skot/bitcart/bitcart.kicad_pcb

## KiCad design bitcart.kicad_pcb (2023-10-17)

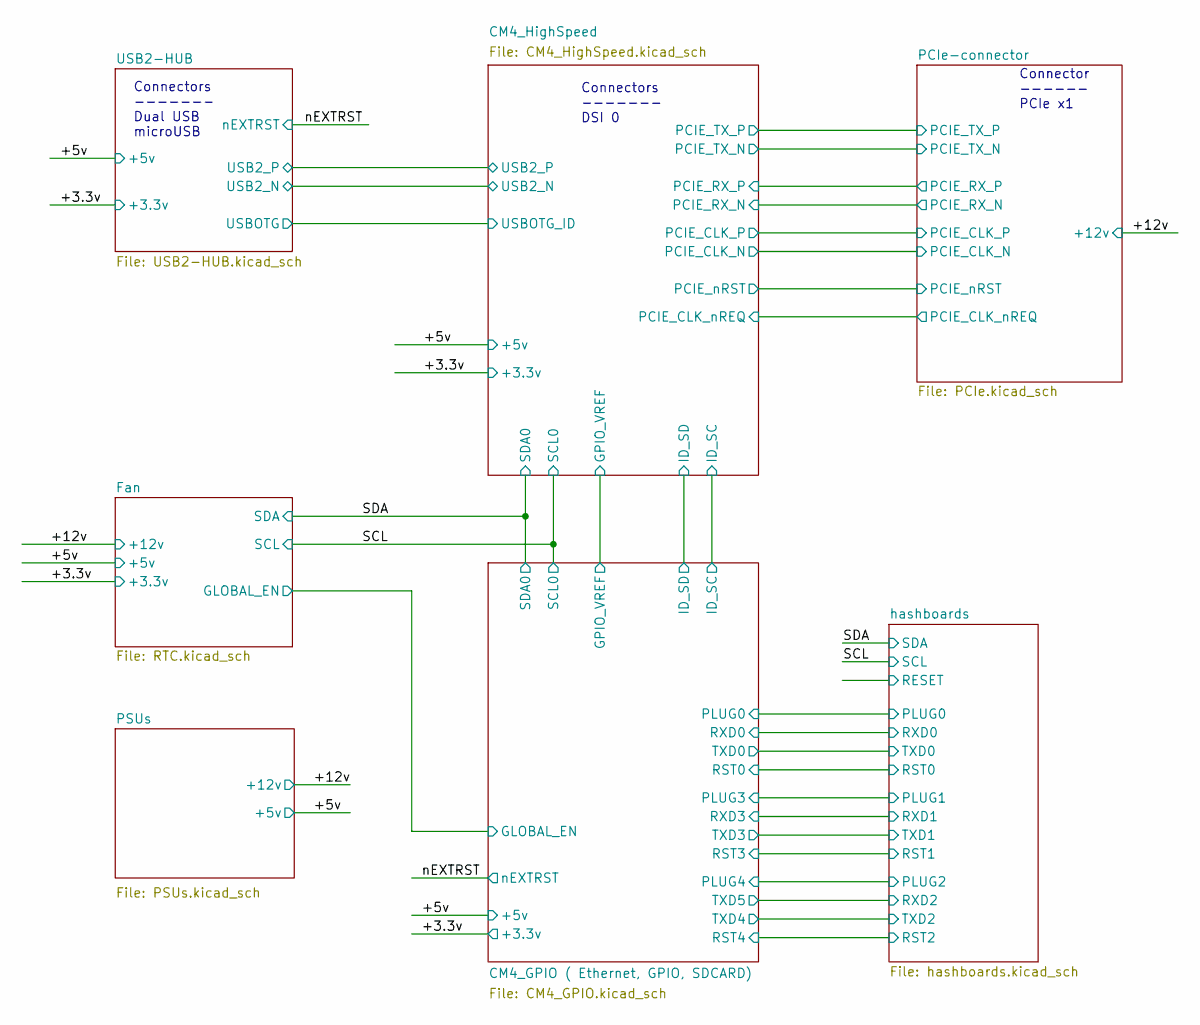
[picture p2: schematic bitcart.kicad_sch]

Notes on the sheet:
Connector ------ PCIe x1
Connectors ------- Dual USB microUSB
Connectors ------- DSI 0

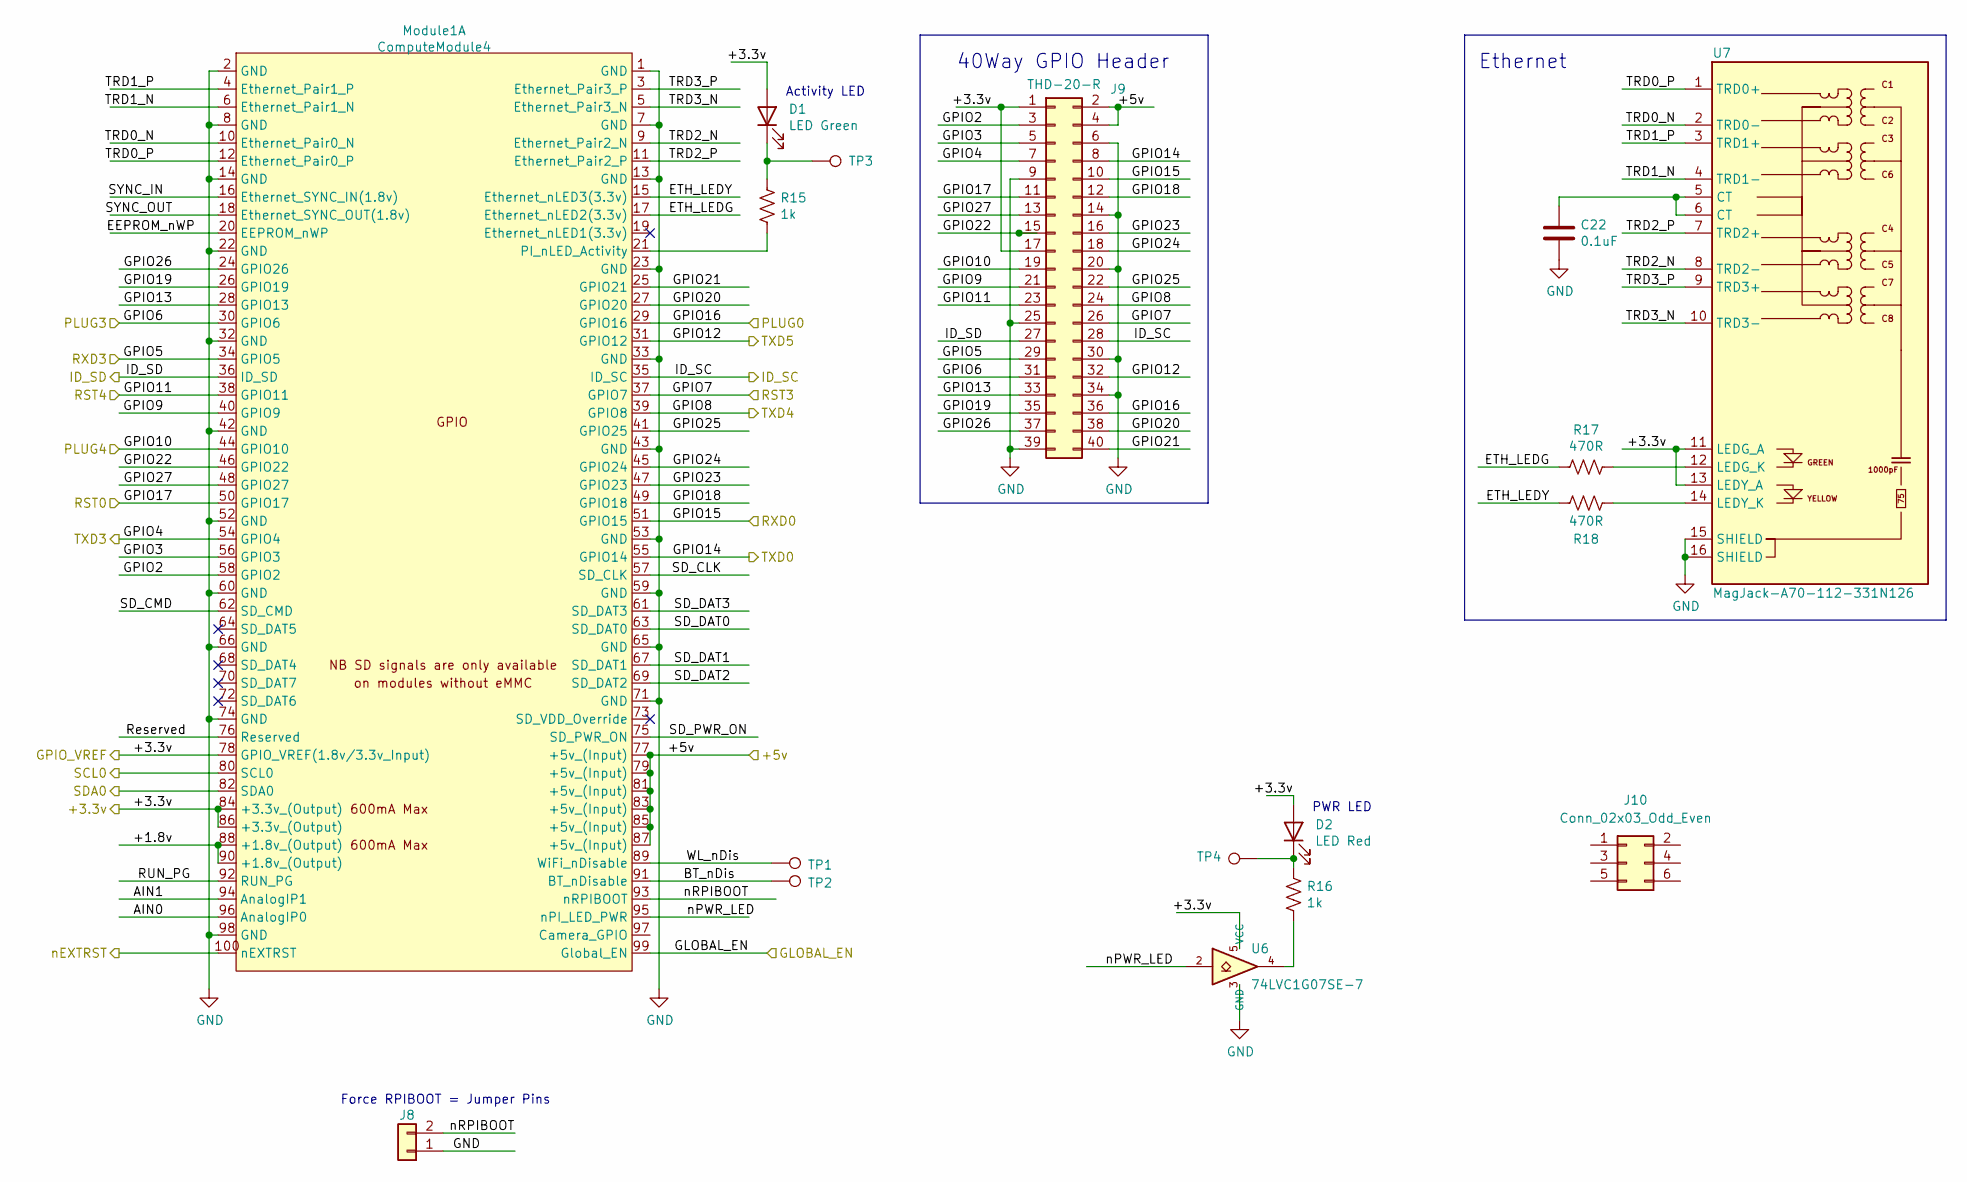
[picture p3: schematic CM4_GPIO.kicad_sch, Bitcart]

Parts:
C22: 0.1uF; C_0402_1005Metric; PARTNO KGM05AR71C104KH
D1: LED Green; LED_0603_1608Metric; PARTNO LTST-S270KGKT
D2: LED Red; LED_0603_1608Metric; Part Description Red 620nm LED Indication - Discrete 2.2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
J8: Conn_01x02; PinHeader_1x02_P2.54mm_Vertical
J9: THD-20-R; PinHeader_2x20_P2.54mm_Vertical; Part Description PinHeader_2x20_P2.54mm_Vertical
J10: Conn_02x03_Odd_Even; CONN-TH_6P-P2.00_PHD-2X3A
Module1: ComputeModule4; Raspberry-Pi-4-Compute-Module; PARTNO DF40C-100DS-0.4V(58)
R15, R16: 1k; R_0402_1005Metric; Part Description Resistor 1K M1005 1% 63mW
R17, R18: 470R; R_0402_1005Metric; Part Description Resistor 470R M1005 1% 63mW
TP1, TP2, TP3, TP4: TestPoint; TestPoint_Pad_D1.5mm
U6: 74LVC1G07SE-7; SOT-353_SC-70-5; PARTNO 74LVC1G07GW,125
U7: MagJack-A70-112-331N126; ARJM11D7-502-AB-EW2_ABR; Part Description Gigabit Ethernet Magjack

Connections:
/+3.3v: D1.2 (A), D2.2 (A), J9.1, J9.17, Module1.78 (GPIO_VREF(1.8v/3.3v_Input)), Module1.84 (+3.3v_(Output)), Module1.86 (+3.3v_(Output)), U6.5 (VCC), U7.11 (LEDG_A), U7.13 (LEDY_A); also elsewhere on the board
/+5v: J9.2, J9.4, Module1.77 (+5v_(Input)), Module1.79 (+5v_(Input)), Module1.81 (+5v_(Input)), Module1.83 (+5v_(Input)), Module1.85 (+5v_(Input)), Module1.87 (+5v_(Input)); also elsewhere on the board
/CM4_GPIO ( Ethernet, GPIO, SDCARD)/+1.8v: Module1.88 (+1.8v_(Output)), Module1.90 (+1.8v_(Output))
/CM4_GPIO ( Ethernet, GPIO, SDCARD)/AIN0: Module1.96 (AnalogIP0)
/CM4_GPIO ( Ethernet, GPIO, SDCARD)/AIN1: Module1.94 (AnalogIP1)
/CM4_GPIO ( Ethernet, GPIO, SDCARD)/BT_nDis: Module1.91 (BT_nDisable), TP2.1
/CM4_GPIO ( Ethernet, GPIO, SDCARD)/EEPROM_nWP: Module1.20 (EEPROM_nWP)
/CM4_GPIO ( Ethernet, GPIO, SDCARD)/ETH_LEDG: Module1.17 (Ethernet_nLED2(3.3v)), R17.2
/CM4_GPIO ( Ethernet, GPIO, SDCARD)/ETH_LEDY: Module1.15 (Ethernet_nLED3(3.3v)), R18.2
/CM4_GPIO ( Ethernet, GPIO, SDCARD)/GLOBAL_EN: Module1.99 (Global_EN)
/CM4_GPIO ( Ethernet, GPIO, SDCARD)/GPIO2: J9.3, Module1.58 (GPIO2)
/CM4_GPIO ( Ethernet, GPIO, SDCARD)/GPIO3: J9.5, Module1.56 (GPIO3)
/CM4_GPIO ( Ethernet, GPIO, SDCARD)/GPIO4: J9.7, Module1.54 (GPIO4); also elsewhere on the board
/CM4_GPIO ( Ethernet, GPIO, SDCARD)/GPIO5: J9.29, Module1.34 (GPIO5); also elsewhere on the board
/CM4_GPIO ( Ethernet, GPIO, SDCARD)/GPIO6: J9.31, Module1.30 (GPIO6); also elsewhere on the board
/CM4_GPIO ( Ethernet, GPIO, SDCARD)/GPIO7: J9.26, Module1.37 (GPIO7); also elsewhere on the board
/CM4_GPIO ( Ethernet, GPIO, SDCARD)/GPIO8: J9.24, Module1.39 (GPIO8); also elsewhere on the board
/CM4_GPIO ( Ethernet, GPIO, SDCARD)/GPIO9: J9.21, Module1.40 (GPIO9)
/CM4_GPIO ( Ethernet, GPIO, SDCARD)/GPIO10: J9.19, Module1.44 (GPIO10); also elsewhere on the board
/CM4_GPIO ( Ethernet, GPIO, SDCARD)/GPIO11: J9.23, Module1.38 (GPIO11); also elsewhere on the board
/CM4_GPIO ( Ethernet, GPIO, SDCARD)/GPIO12: J9.32, Module1.31 (GPIO12); also elsewhere on the board
/CM4_GPIO ( Ethernet, GPIO, SDCARD)/GPIO13: J9.33, Module1.28 (GPIO13)
/CM4_GPIO ( Ethernet, GPIO, SDCARD)/GPIO14: J9.8, Module1.55 (GPIO14); also elsewhere on the board
/CM4_GPIO ( Ethernet, GPIO, SDCARD)/GPIO15: J9.10, Module1.51 (GPIO15); also elsewhere on the board
/CM4_GPIO ( Ethernet, GPIO, SDCARD)/GPIO16: J9.36, Module1.29 (GPIO16); also elsewhere on the board
/CM4_GPIO ( Ethernet, GPIO, SDCARD)/GPIO17: J9.11, Module1.50 (GPIO17); also elsewhere on the board
/CM4_GPIO ( Ethernet, GPIO, SDCARD)/GPIO18: J9.12, Module1.49 (GPIO18)
/CM4_GPIO ( Ethernet, GPIO, SDCARD)/GPIO19: J9.35, Module1.26 (GPIO19)
/CM4_GPIO ( Ethernet, GPIO, SDCARD)/GPIO20: J9.38, Module1.27 (GPIO20)
/CM4_GPIO ( Ethernet, GPIO, SDCARD)/GPIO21: J9.40, Module1.25 (GPIO21)
/CM4_GPIO ( Ethernet, GPIO, SDCARD)/GPIO22: J9.15, Module1.46 (GPIO22)
/CM4_GPIO ( Ethernet, GPIO, SDCARD)/GPIO23: J9.16, Module1.47 (GPIO23)
/CM4_GPIO ( Ethernet, GPIO, SDCARD)/GPIO24: J9.18, Module1.45 (GPIO24)
/CM4_GPIO ( Ethernet, GPIO, SDCARD)/GPIO25: J9.22, Module1.41 (GPIO25)
/CM4_GPIO ( Ethernet, GPIO, SDCARD)/GPIO26: J9.37, Module1.24 (GPIO26)
/CM4_GPIO ( Ethernet, GPIO, SDCARD)/GPIO27: J9.13, Module1.48 (GPIO27)
/CM4_GPIO ( Ethernet, GPIO, SDCARD)/ID_SC: J9.28, Module1.35 (ID_SC); also elsewhere on the board
/CM4_GPIO ( Ethernet, GPIO, SDCARD)/ID_SD: J9.27, Module1.36 (ID_SD); also elsewhere on the board
/CM4_GPIO ( Ethernet, GPIO, SDCARD)/RUN_PG: Module1.92 (RUN_PG)
/CM4_GPIO ( Ethernet, GPIO, SDCARD)/Reserved: Module1.76 (Reserved)
/CM4_GPIO ( Ethernet, GPIO, SDCARD)/SD_CLK: Module1.57 (SD_CLK)
/CM4_GPIO ( Ethernet, GPIO, SDCARD)/SD_CMD: Module1.62 (SD_CMD)
/CM4_GPIO ( Ethernet, GPIO, SDCARD)/SD_DAT0: Module1.63 (SD_DAT0)
/CM4_GPIO ( Ethernet, GPIO, SDCARD)/SD_DAT1: Module1.67 (SD_DAT1)
/CM4_GPIO ( Ethernet, GPIO, SDCARD)/SD_DAT2: Module1.69 (SD_DAT2)
/CM4_GPIO ( Ethernet, GPIO, SDCARD)/SD_DAT3: Module1.61 (SD_DAT3)
/CM4_GPIO ( Ethernet, GPIO, SDCARD)/SD_PWR_ON: Module1.75 (SD_PWR_ON)
/CM4_GPIO ( Ethernet, GPIO, SDCARD)/SYNC_IN: Module1.16 (Ethernet_SYNC_IN(1.8v))
/CM4_GPIO ( Ethernet, GPIO, SDCARD)/SYNC_OUT: Module1.18 (Ethernet_SYNC_OUT(1.8v))
/CM4_GPIO ( Ethernet, GPIO, SDCARD)/TRD0_N: Module1.10 (Ethernet_Pair0_N), U7.2 (TRD0-)
/CM4_GPIO ( Ethernet, GPIO, SDCARD)/TRD0_P: Module1.12 (Ethernet_Pair0_P), U7.1 (TRD0+)
/CM4_GPIO ( Ethernet, GPIO, SDCARD)/TRD1_N: Module1.6 (Ethernet_Pair1_N), U7.4 (TRD1-)
/CM4_GPIO ( Ethernet, GPIO, SDCARD)/TRD1_P: Module1.4 (Ethernet_Pair1_P), U7.3 (TRD1+)
/CM4_GPIO ( Ethernet, GPIO, SDCARD)/TRD2_N: Module1.9 (Ethernet_Pair2_N), U7.8 (TRD2-)
/CM4_GPIO ( Ethernet, GPIO, SDCARD)/TRD2_P: Module1.11 (Ethernet_Pair2_P), U7.7 (TRD2+)
/CM4_GPIO ( Ethernet, GPIO, SDCARD)/TRD3_N: Module1.5 (Ethernet_Pair3_N), U7.10 (TRD3-)
/CM4_GPIO ( Ethernet, GPIO, SDCARD)/TRD3_P: Module1.3 (Ethernet_Pair3_P), U7.9 (TRD3+)
/CM4_GPIO ( Ethernet, GPIO, SDCARD)/WL_nDis: Module1.89 (WiFi_nDisable), TP1.1
/CM4_GPIO ( Ethernet, GPIO, SDCARD)/nPWR_LED: Module1.95 (nPI_LED_PWR), U6.2
/CM4_GPIO ( Ethernet, GPIO, SDCARD)/nRPIBOOT: J8.2, Module1.93 (nRPIBOOT)
/SCL: Module1.80 (SCL0); also elsewhere on the board
/SDA: Module1.82 (SDA0); also elsewhere on the board
/nEXTRST: Module1.100 (nEXTRST); also elsewhere on the board
unnamed: C22.1, U7.5 (CT), U7.6 (CT)
unnamed: D1.1 (K), R15.1, TP3.1
unnamed: D2.1 (K), R16.1, TP4.1
unnamed: Module1.21 (PI_nLED_Activity), R15.2
unnamed: R16.2, U6.4
unnamed: R17.1, U7.12 (LEDG_K)
unnamed: R18.1, U7.14 (LEDY_K)

Notes on the sheet:
PWR LED
40Way GPIO Header
Ethernet
Activity LED
Force RPIBOOT = Jumper Pins

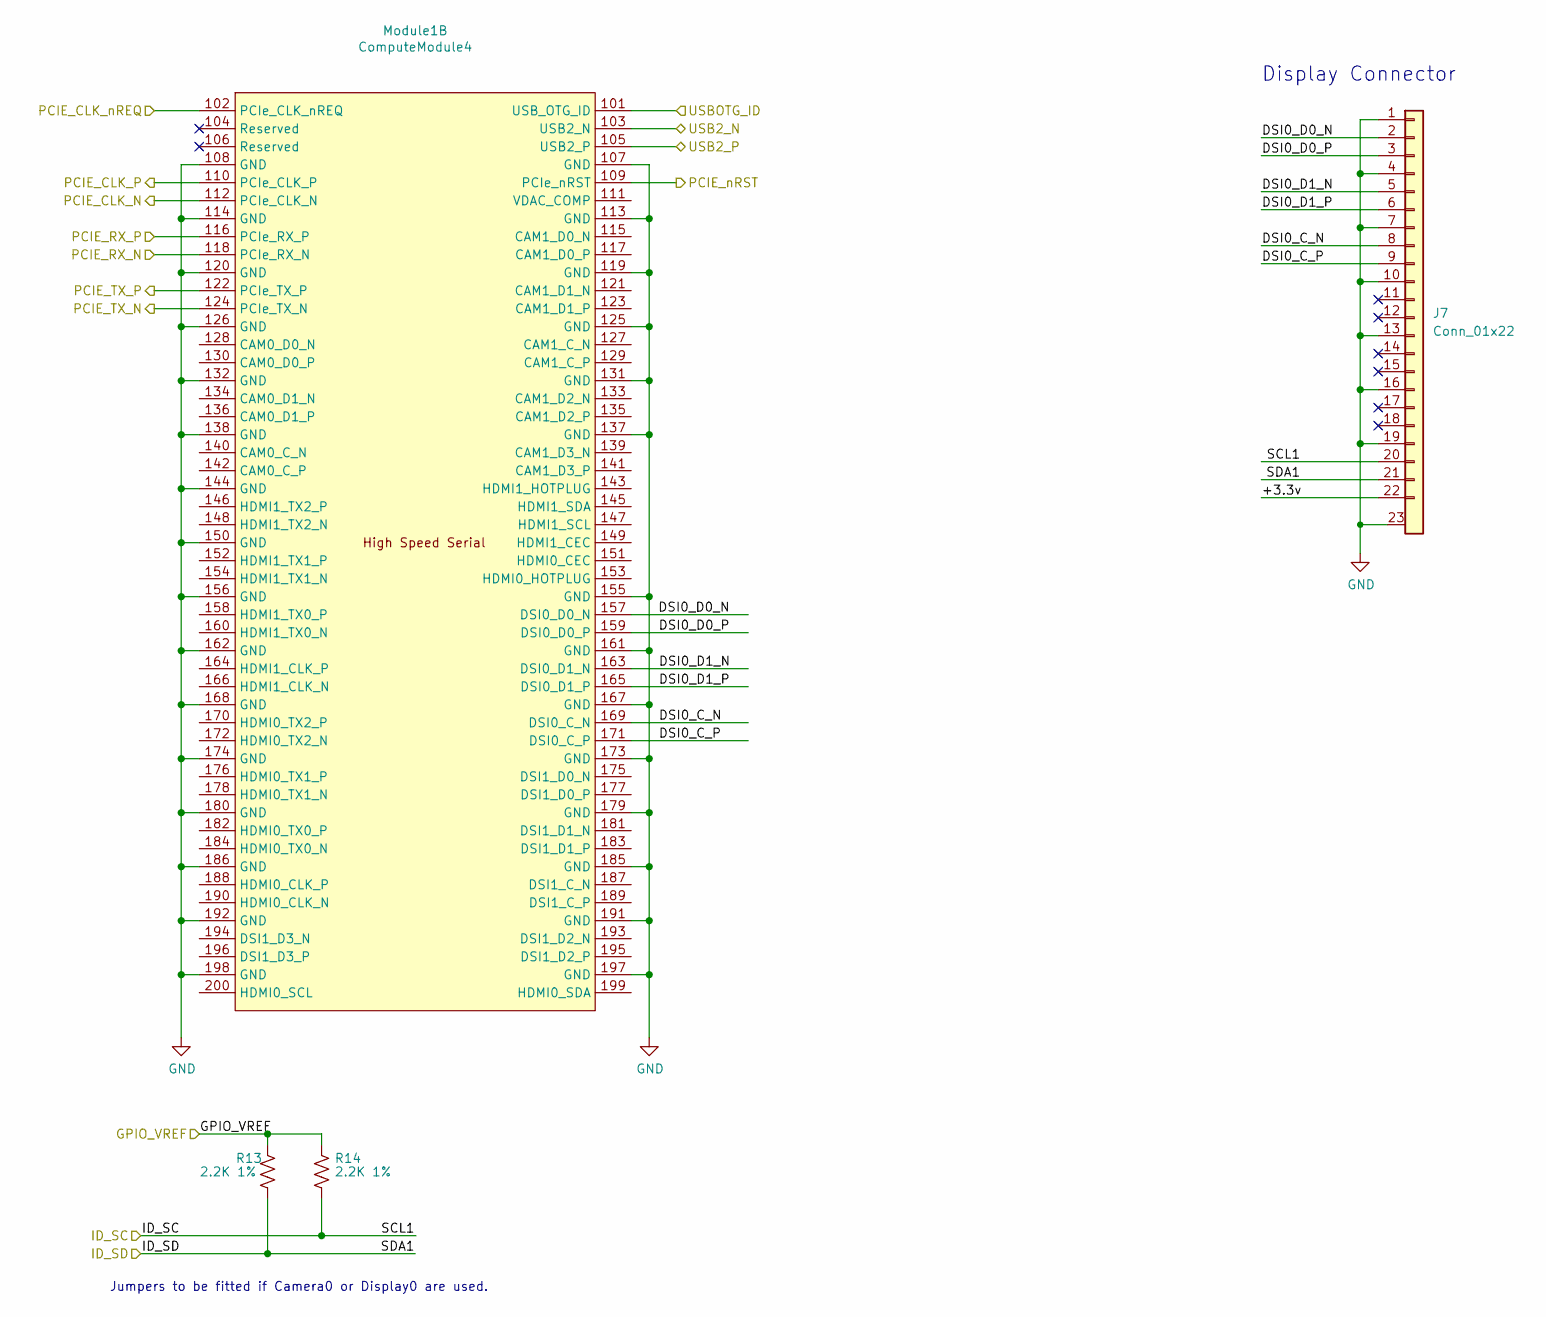
[picture p4: schematic CM4_HighSpeed.kicad_sch, Bitcart]

Parts:
J7: Conn_01x22; CON22_1X22_DUTB_HRS_HIR; PARTNO FH12-22S-0.5SVA(54)
Module1: ComputeModule4; Raspberry-Pi-4-Compute-Module; PARTNO DF40C-100DS-0.4V(58)
R13, R14: 2.2K 1%; R_0402_1005Metric; PARTNO RC0402FR-072K2L

Connections:
/CM4_GPIO ( Ethernet, GPIO, SDCARD)/+3.3v: R13.1, R14.1
/CM4_GPIO ( Ethernet, GPIO, SDCARD)/ID_SC: J7.20, R14.2; also elsewhere on the board
/CM4_GPIO ( Ethernet, GPIO, SDCARD)/ID_SD: J7.21, R13.2; also elsewhere on the board
/CM4_HighSpeed/+3.3v: J7.22
/CM4_HighSpeed/DSI0_C_N: J7.8, Module1.169 (DSI0_C_N)
/CM4_HighSpeed/DSI0_C_P: J7.9, Module1.171 (DSI0_C_P)
/CM4_HighSpeed/DSI0_D0_N: J7.2, Module1.157 (DSI0_D0_N)
/CM4_HighSpeed/DSI0_D0_P: J7.3, Module1.159 (DSI0_D0_P)
/CM4_HighSpeed/DSI0_D1_N: J7.5, Module1.163 (DSI0_D1_N)
/CM4_HighSpeed/DSI0_D1_P: J7.6, Module1.165 (DSI0_D1_P)
/CM4_HighSpeed/PCIE_CLK_N: Module1.112 (PCIe_CLK_N); also elsewhere on the board
/CM4_HighSpeed/PCIE_CLK_P: Module1.110 (PCIe_CLK_P); also elsewhere on the board
/CM4_HighSpeed/PCIE_CLK_nREQ: Module1.102 (PCIe_CLK_nREQ); also elsewhere on the board
/CM4_HighSpeed/PCIE_RX_N: Module1.118 (PCIe_RX_N); also elsewhere on the board
/CM4_HighSpeed/PCIE_RX_P: Module1.116 (PCIe_RX_P); also elsewhere on the board
/CM4_HighSpeed/PCIE_TX_N: Module1.124 (PCIe_TX_N); also elsewhere on the board
/CM4_HighSpeed/PCIE_TX_P: Module1.122 (PCIe_TX_P); also elsewhere on the board
/CM4_HighSpeed/PCIE_nRST: Module1.109 (PCIe_nRST); also elsewhere on the board
/CM4_HighSpeed/USB2_N: Module1.103 (USB2_N); also elsewhere on the board
/CM4_HighSpeed/USB2_P: Module1.105 (USB2_P); also elsewhere on the board
/CM4_HighSpeed/USBOTG_ID: Module1.101 (USB_OTG_ID); also elsewhere on the board

Notes on the sheet:
Jumpers to be fitted if Camera0 or Display0 are used.
Display Connector

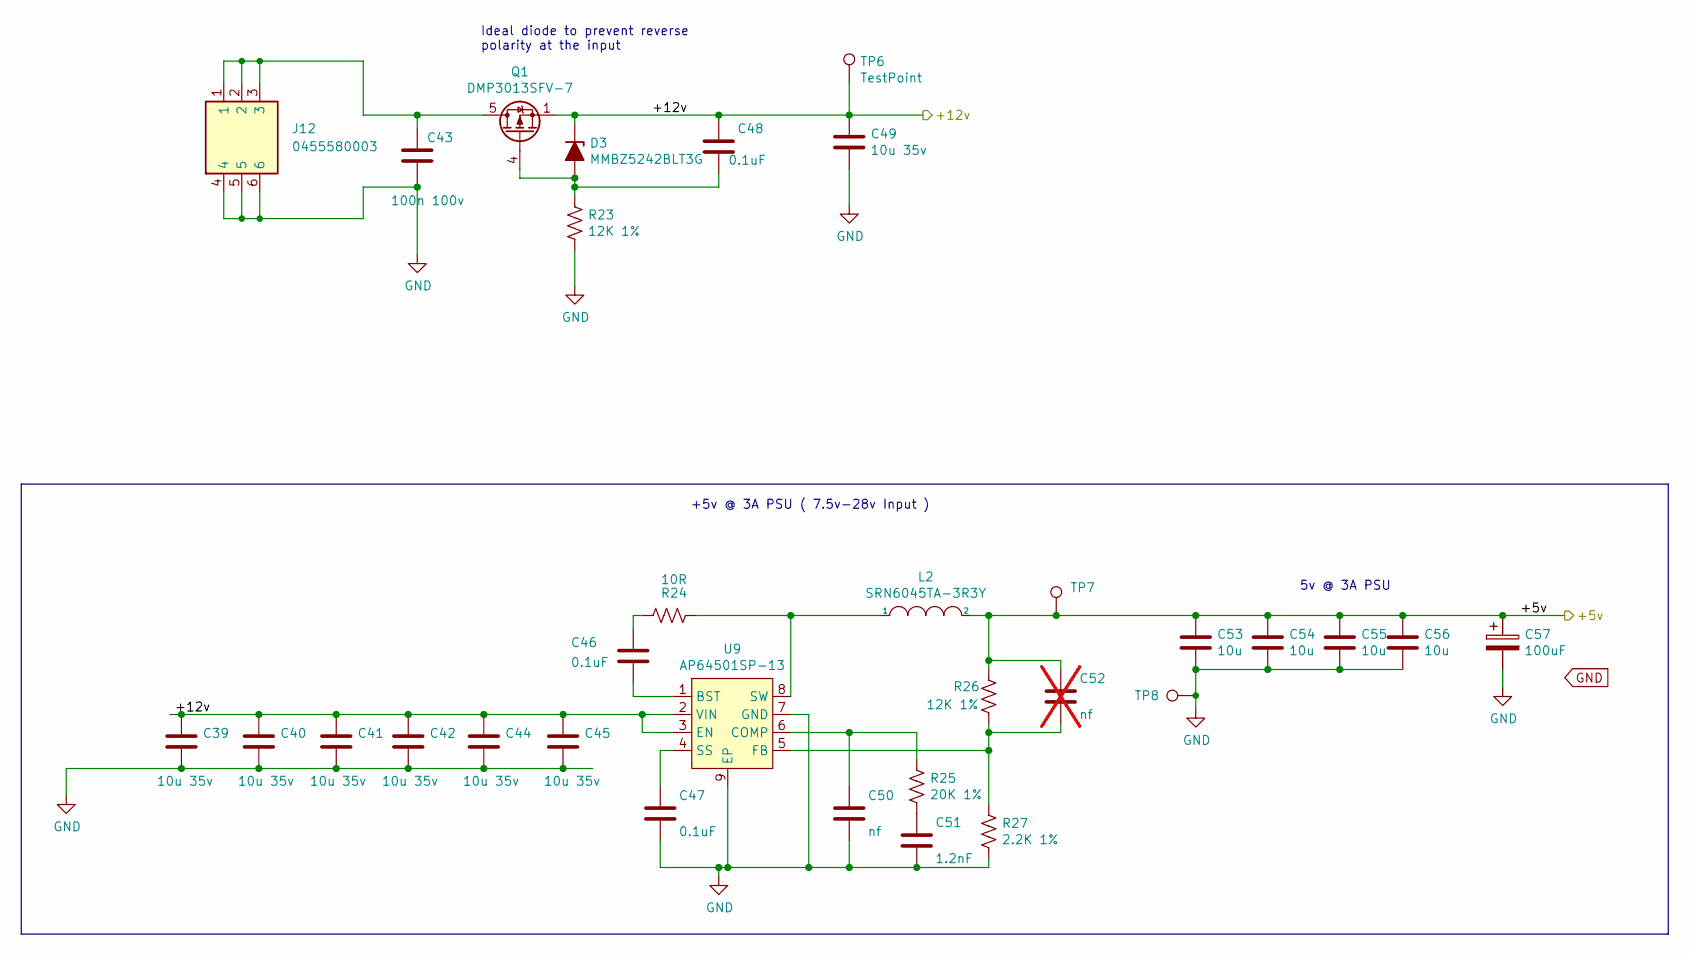
[picture p5: schematic PSUs.kicad_sch, Bitcart]

Parts:
C39, C40, C41, C42, C44, C45, C49: 10u 35v; C_0805_2012Metric; Part Description 10uF 10% or 20% 35V Ceramic Capacitor X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
C43: 100n 100v; C_0402_1005Metric; Part Description 0.1uF 10% 100V Ceramic Capacitor X5R 04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
C46, C47, C48: 0.1uF; C_0402_1005Metric; PARTNO KGM05AR71C104KH
C50: nf; C_0402_1005Metric
C51: 1.2nF; C_0402_1005Metric; Part Description 1200pF 10% 10V Ceramic Capacitor X5R 04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
C52: nf; C_0402_1005Metric; Part Description 220 pF, 50 V, 0402 [1005 Metric], ± 5%,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; not fitted
C53, C54, C55, C56: 10u; C_0805_2012Metric; Part Description 10uF 10% 10V Ceramic Capacitor X7R 0805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
C57: 100uF; CP_EIA-7343-31_Kemet-D; Part Description Capacitor, SP-Cap, 100u, 6.3V, 15mR ESR
D3: MMBZ5242BLT3G; D_SOT-23_ANK; PARTNO MMBZ5242BLT3G
J12: 0455580003; PARTNO 0455580003
L2: SRN6045TA-3R3Y; L_Bourns_SRN6045TA
Q1: DMP3013SFV-7; Diodes_PowerDI3333-8; PARTNO DMP3013SFV-7
R23, R26: 12K 1%; R_0402_1005Metric; Part Description Resistor 12K M1005 1% 63mW
R24: 10R; R_0402_1005Metric; Part Description Resistor 10R M1005 1% 63mW
R25: 20K 1%; R_0402_1005Metric; Part Description Resistor 20K M1005 1% 63mW
R27: 2.2K 1%; R_0402_1005Metric; Part Description Resistor 2.2K M1005 1% 63mW
TP6, TP7, TP8: TestPoint; TestPoint_Pad_D1.5mm
U9: AP64501SP-13; SOIC-8-1EP_3.9x4.9mm_P1.27mm_EP2.95x4.9mm_Mask2.71x3.4mm_Th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; PARTNO AP64501SP-13

Connections:
/+5v: C52.1, C53.1, C54.1, C55.1, C56.1, C57.1, L2.2, R26.1, TP7.1; also elsewhere on the board
unnamed: C46.1, R24.2
unnamed: C51.1, R25.2
unnamed: C48.2, D3.1 (A), Q1.4 (G), R23.1
unnamed: C43.1, J12.1, J12.2, J12.3, Q1.5 (D)
unnamed: C46.2, U9.1 (BST)
unnamed: C50.1, R25.1, U9.6 (COMP)
unnamed: C52.2, R26.2, R27.1, U9.5 (FB)
unnamed: C47.1, U9.4 (SS)
unnamed: L2.1, R24.1, U9.8 (SW)

Notes on the sheet:
5v @ 3A PSU
Ideal diode to prevent reverse polarity at the input
+5v @ 3A PSU ( 7.5v-28v Input )

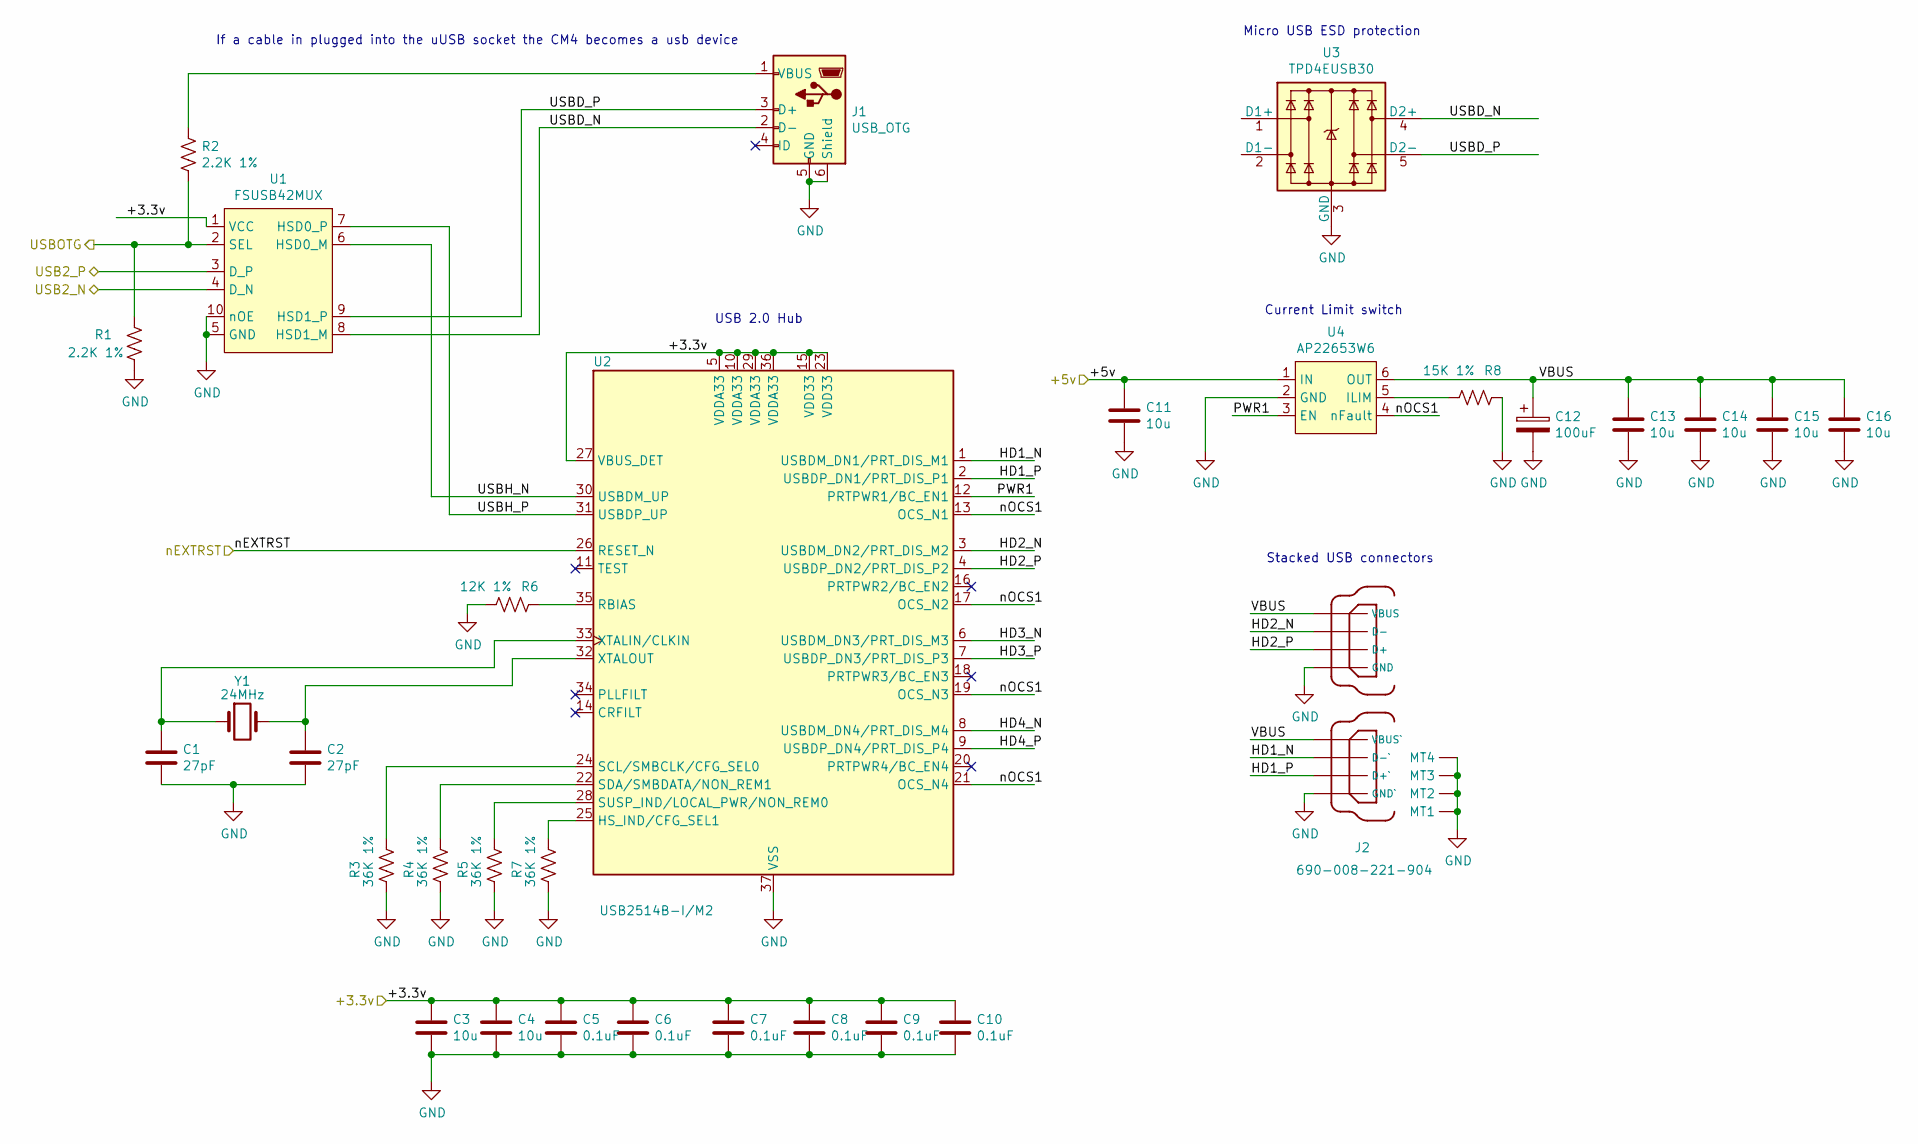
[picture p6: schematic USB2-HUB.kicad_sch, Bitcart]

Parts:
C1, C2: 27pF; C_0402_1005Metric; Part Description 27pF 5% 50V Ceramic Capacitor C0G, NP0 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
C3, C4, C11, C13, C14, C15, C16: 10u; C_0805_2012Metric; Part Description 10uF 10% 10V Ceramic Capacitor X7R 0805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
C5, C6, C7, C8, C9, C10: 0.1uF; C_0402_1005Metric; PARTNO KGM05AR71C104KH
C12: 100uF; CP_EIA-7343-31_Kemet-D; Part Description Capacitor, SP-Cap, 100u, 6.3V, 15mR ESR
J1: USB_OTG; USB_Micro-B_EDAC_UCON00686; PARTNO 10103594-0001LF
J2: 690-008-221-904; MOLEX_USB_67298-4090; PARTNO 0672984090
R1, R2: 2.2K 1%; R_0402_1005Metric; Part Description Resistor 2.2K M1005 1% 63mW
R3, R4, R5, R7: 36K 1%; R_0402_1005Metric; Part Description Resistor 36K M1005 1% 63mW
R6: 12K 1%; R_0402_1005Metric; Part Description Resistor 12K M1005 1% 63mW
R8: 15K 1%; R_0402_1005Metric; Part Description Resistor 15K M1005 1% 63mW
U1: FSUSB42MUX; MSOP-10_3x3mm_P0.5mm; PARTNO FSUSB42MUX
U2: USB2514B-I/M2; QFN-36-1EP_6x6mm_P0.5mm_EP3.7x3.7mm; PARTNO USB2514B-I/M2
U3: TPD4EUSB30; USON-10_2.5x1.0mm_P0.5mm; PARTNO TPD4EUSB30DQAR
U4: AP22653W6; SOT-23-6; PARTNO AP2553W6-7
Y1: 24MHz; CRYSTAL_ABM8G_ABR; PARTNO ABM8G-24.000MHZ-18-D2Y-T

Connections:
/+3.3v: C3.1, C4.1, C5.1, C6.1, C7.1, C8.1, C9.1, C10.1, U1.1 (VCC), U2.5 (VDDA33), U2.10 (VDDA33), U2.15 (VDD33), U2.23 (VDD33), U2.27 (VBUS_DET), U2.29 (VDDA33), U2.36 (VDDA33); also elsewhere on the board
/+5v: C11.1, U4.1 (IN); also elsewhere on the board
/CM4_HighSpeed/USB2_N: U1.4 (D_N); also elsewhere on the board
/CM4_HighSpeed/USB2_P: U1.3 (D_P); also elsewhere on the board
/CM4_HighSpeed/USBOTG_ID: R1.1, R2.2, U1.2 (SEL); also elsewhere on the board
/USB2-HUB/HD1_N: J2.2 (D-`), U2.1 (USBDM_DN1/PRT_DIS_M1)
/USB2-HUB/HD1_P: J2.3 (D+`), U2.2 (USBDP_DN1/PRT_DIS_P1)
/USB2-HUB/HD2_N: J2.6 (D-), U2.3 (USBDM_DN2/PRT_DIS_M2)
/USB2-HUB/HD2_P: J2.7 (D+), U2.4 (USBDP_DN2/PRT_DIS_P2)
/USB2-HUB/HD3_N: U2.6 (USBDM_DN3/PRT_DIS_M3)
/USB2-HUB/HD3_P: U2.7 (USBDP_DN3/PRT_DIS_P3)
/USB2-HUB/HD4_N: U2.8 (USBDM_DN4/PRT_DIS_M4)
/USB2-HUB/HD4_P: U2.9 (USBDP_DN4/PRT_DIS_P4)
/USB2-HUB/PWR1: U2.12 (PRTPWR1/BC_EN1), U4.3 (EN)
/USB2-HUB/USBD_N: J1.2 (D-), U1.8 (HSD1_M), U3.4 (D2+), U3.7
/USB2-HUB/USBD_P: J1.3 (D+), U1.9 (HSD1_P), U3.5 (D2-), U3.6
/USB2-HUB/USBH_N: U1.6 (HSD0_M), U2.30 (USBDM_UP)
/USB2-HUB/USBH_P: U1.7 (HSD0_P), U2.31 (USBDP_UP)
/USB2-HUB/VBUS: C12.1, C13.1, C14.1, C15.1, C16.1, J2.1 (VBUS`), J2.5 (VBUS), U4.6 (OUT)
/USB2-HUB/nOCS1: U2.13 (OCS_N1), U2.17 (OCS_N2), U2.19 (OCS_N3), U2.21 (OCS_N4), U4.4 (nFault)
/nEXTRST: U2.26 (RESET_N); also elsewhere on the board
unnamed: J1.1 (VBUS), R2.1
unnamed: R7.1, U2.25 (HS_IND/CFG_SEL1)
unnamed: R6.2, U2.35 (RBIAS)
unnamed: R3.1, U2.24 (SCL/SMBCLK/CFG_SEL0)
unnamed: R4.1, U2.22 (SDA/SMBDATA/NON_REM1)
unnamed: R5.1, U2.28 (SUSP_IND/LOCAL_PWR/NON_REM0)
unnamed: C1.1, U2.33 (XTALIN/CLKIN), Y1.1
unnamed: C2.1, U2.32 (XTALOUT), Y1.3
unnamed: U3.1 (D1+), U3.10
unnamed: U3.2 (D1-), U3.9
unnamed: R8.1, U4.5 (ILIM)

Notes on the sheet:
Current Limit switch
USB 2.0 Hub
If a cable in plugged into the uUSB socket the CM4 becomes a usb device
Micro USB ESD protection
Stacked USB connectors

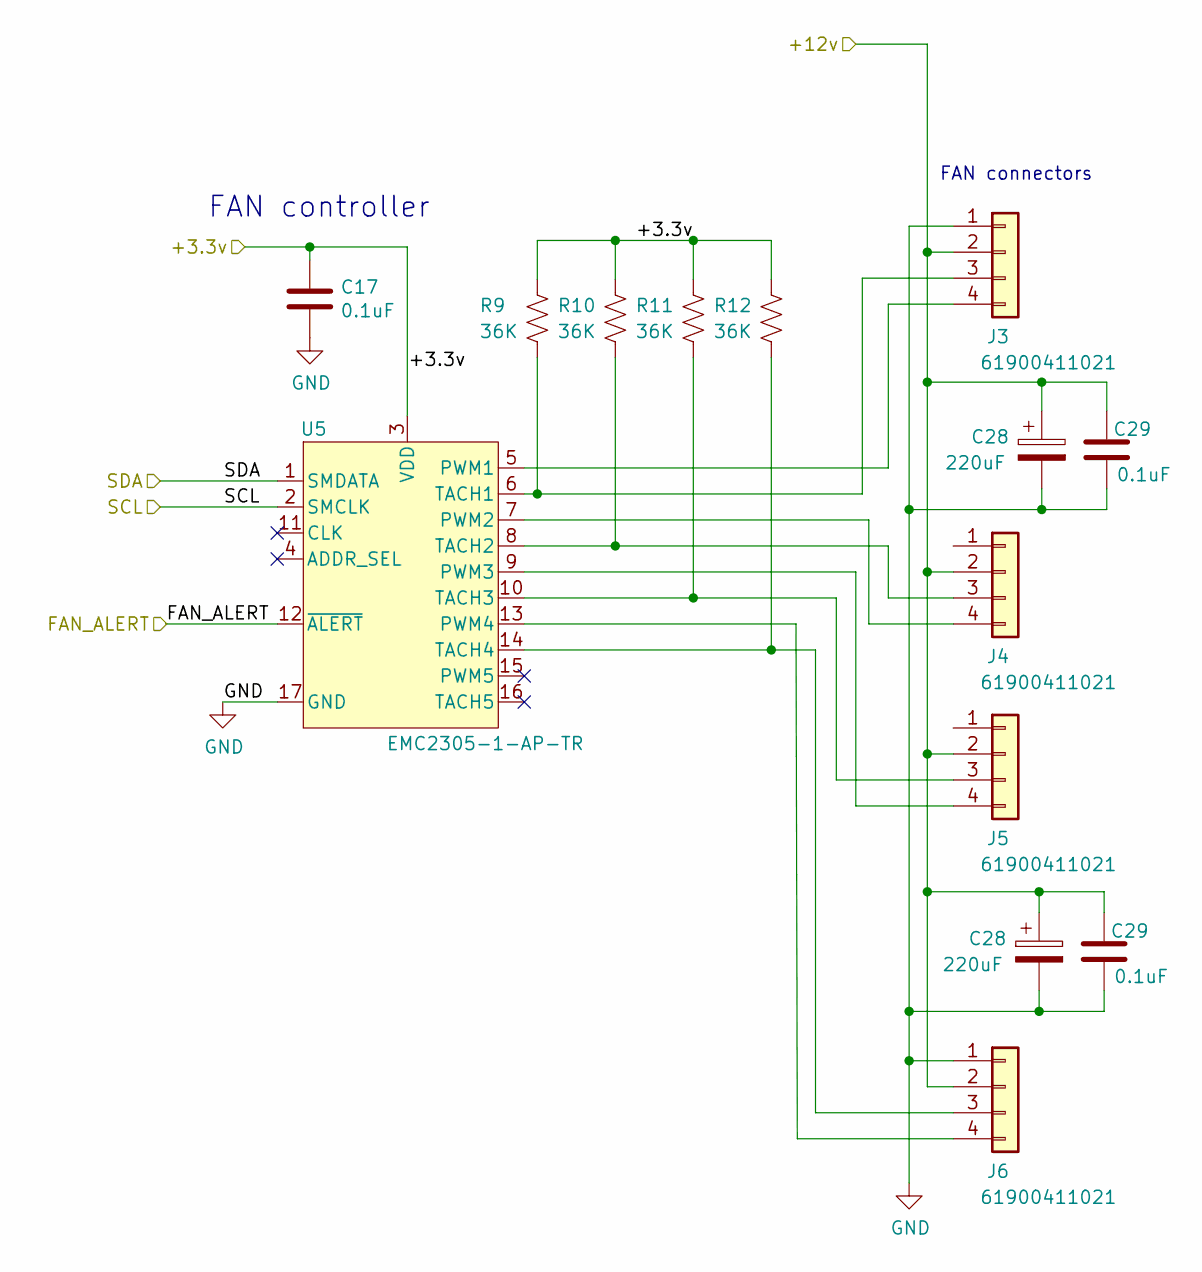
[picture p7: schematic RTC.kicad_sch, Bitcart]

Parts:
C17: 0.1uF; C_0402_1005Metric; PARTNO KGM05AR71C104KH
C28: 220uF; CP_Elec_6.3x7.7; PARTNO 865080345012
C29: 0.1uF; C_0402_1005Metric; PARTNO 0402X104K100CT
J3, J4, J5, J6: 61900411021; CONN_61900411021_WRE; PARTNO 61900411021
R9, R10, R11, R12: 36K; R_0402_1005Metric; PARTNO CR0402-FX-3602GLF
U5: EMC2305-1-AP-TR; QFN16_4x4MC_MCH

Connections:
/+3.3v: C17.1, R9.1, R10.1, R11.1, R12.1, U5.3 (VDD); also elsewhere on the board
/Fan/FAN_ALERT: U5.12 (~ALERT)
/SCL: U5.2 (SMCLK); also elsewhere on the board
/SDA: U5.1 (SMDATA); also elsewhere on the board
unnamed: J3.3, R9.2, U5.6 (TACH1)
unnamed: J3.4, U5.5 (PWM1)
unnamed: J4.3, R10.2, U5.8 (TACH2)
unnamed: J4.4, U5.7 (PWM2)
unnamed: J5.3, R11.2, U5.10 (TACH3)
unnamed: J5.4, U5.9 (PWM3)
unnamed: J6.3, R12.2, U5.14 (TACH4)
unnamed: J6.4, U5.13 (PWM4)

Notes on the sheet:
FAN controller
FAN connectors

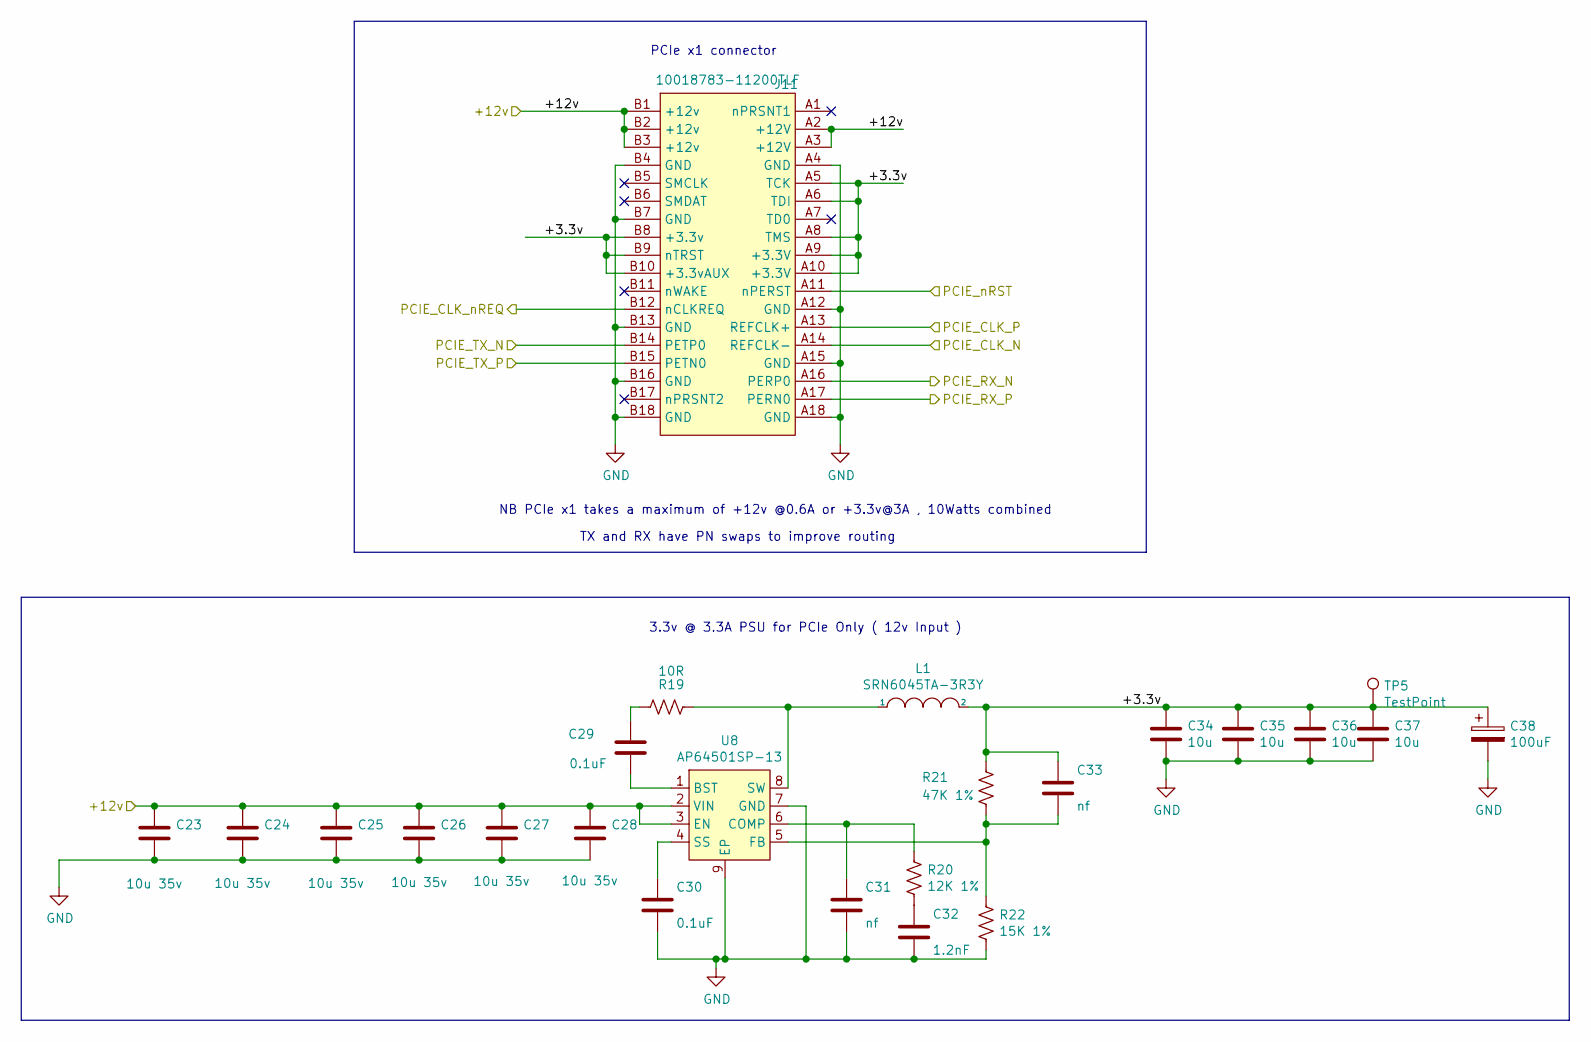
[picture p8: schematic PCIe.kicad_sch, Bitcart]

Parts:
C23, C24, C25, C26, C27, C28: 10u 35v; C_0805_2012Metric; Part Description 10uF 10% or 20% 35V Ceramic Capacitor X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
C29, C30: 0.1uF; C_0402_1005Metric; PARTNO KGM05AR71C104KH
C31: nf; C_0402_1005Metric
C32: 1.2nF; C_0402_1005Metric; Part Description 1200pF 10% 10V Ceramic Capacitor X5R 04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
C33: nf; C_0402_1005Metric; Part Description 27pF 5% 50V Ceramic Capacitor C0G, NP0 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
C34, C35, C36, C37: 10u; C_0805_2012Metric; Part Description 10uF 10% 10V Ceramic Capacitor X7R 0805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
C38: 100uF; CP_EIA-7343-31_Kemet-D; Part Description Capacitor, SP-Cap, 100u, 6.3V, 15mR ESR
J11: 10018783-11200TLF; PCIex1-36; PARTNO 10018783-11200TLF
L1: SRN6045TA-3R3Y; L_Bourns_SRN6045TA
R19: 10R; R_0402_1005Metric; Part Description Resistor 10R M1005 1% 63mW
R20: 12K 1%; R_0402_1005Metric; Part Description Resistor 12K M1005 1% 63mW
R21: 47K 1%; R_0402_1005Metric; Part Description Resistor 47K M1005 1% 63mW
R22: 15K 1%; R_0402_1005Metric; Part Description Resistor 15K M1005 1% 63mW
TP5: TestPoint; TestPoint_Pad_D1.5mm
U8: AP64501SP-13; SOIC-8-1EP_3.9x4.9mm_P1.27mm_EP2.95x4.9mm_Mask2.71x3.4mm_Th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; PARTNO AP64501SP-13

Connections:
/CM4_HighSpeed/PCIE_CLK_N: J11.A14 (REFCLK-); also elsewhere on the board
/CM4_HighSpeed/PCIE_CLK_P: J11.A13 (REFCLK+); also elsewhere on the board
/CM4_HighSpeed/PCIE_CLK_nREQ: J11.B12 (nCLKREQ); also elsewhere on the board
/CM4_HighSpeed/PCIE_RX_N: J11.A16 (PERP0); also elsewhere on the board
/CM4_HighSpeed/PCIE_RX_P: J11.A17 (PERN0); also elsewhere on the board
/CM4_HighSpeed/PCIE_TX_N: J11.B14 (PETP0); also elsewhere on the board
/CM4_HighSpeed/PCIE_TX_P: J11.B15 (PETN0); also elsewhere on the board
/CM4_HighSpeed/PCIE_nRST: J11.A11 (nPERST); also elsewhere on the board
/PCIe-connector/+3.3v: C33.1, C34.1, C35.1, C36.1, C37.1, C38.1, J11.A5 (TCK), J11.A6 (TDI), J11.A8 (TMS), J11.A9 (+3.3V), J11.A10 (+3.3V), J11.B8 (+3.3v), J11.B9 (nTRST), J11.B10 (+3.3vAUX), L1.2, R21.1, TP5.1
unnamed: C32.1, R20.2
unnamed: C31.1, R20.1, U8.6 (COMP)
unnamed: C33.2, R21.2, R22.1, U8.5 (FB)
unnamed: C30.1, U8.4 (SS)
unnamed: L1.1, R19.1, U8.8 (SW)

Notes on the sheet:
TX and RX have PN swaps to improve routing
PCIe x1 connector
3.3v @ 3.3A PSU for PCIe Only ( 12v Input )
NB PCIe x1 takes a maximum of +12v @0.6A or +3.3v@3A , 10Watts combined
