skot/bitcart/bitcart.kicad_pcb

## KiCad design bitcart.kicad_pcb (continued)

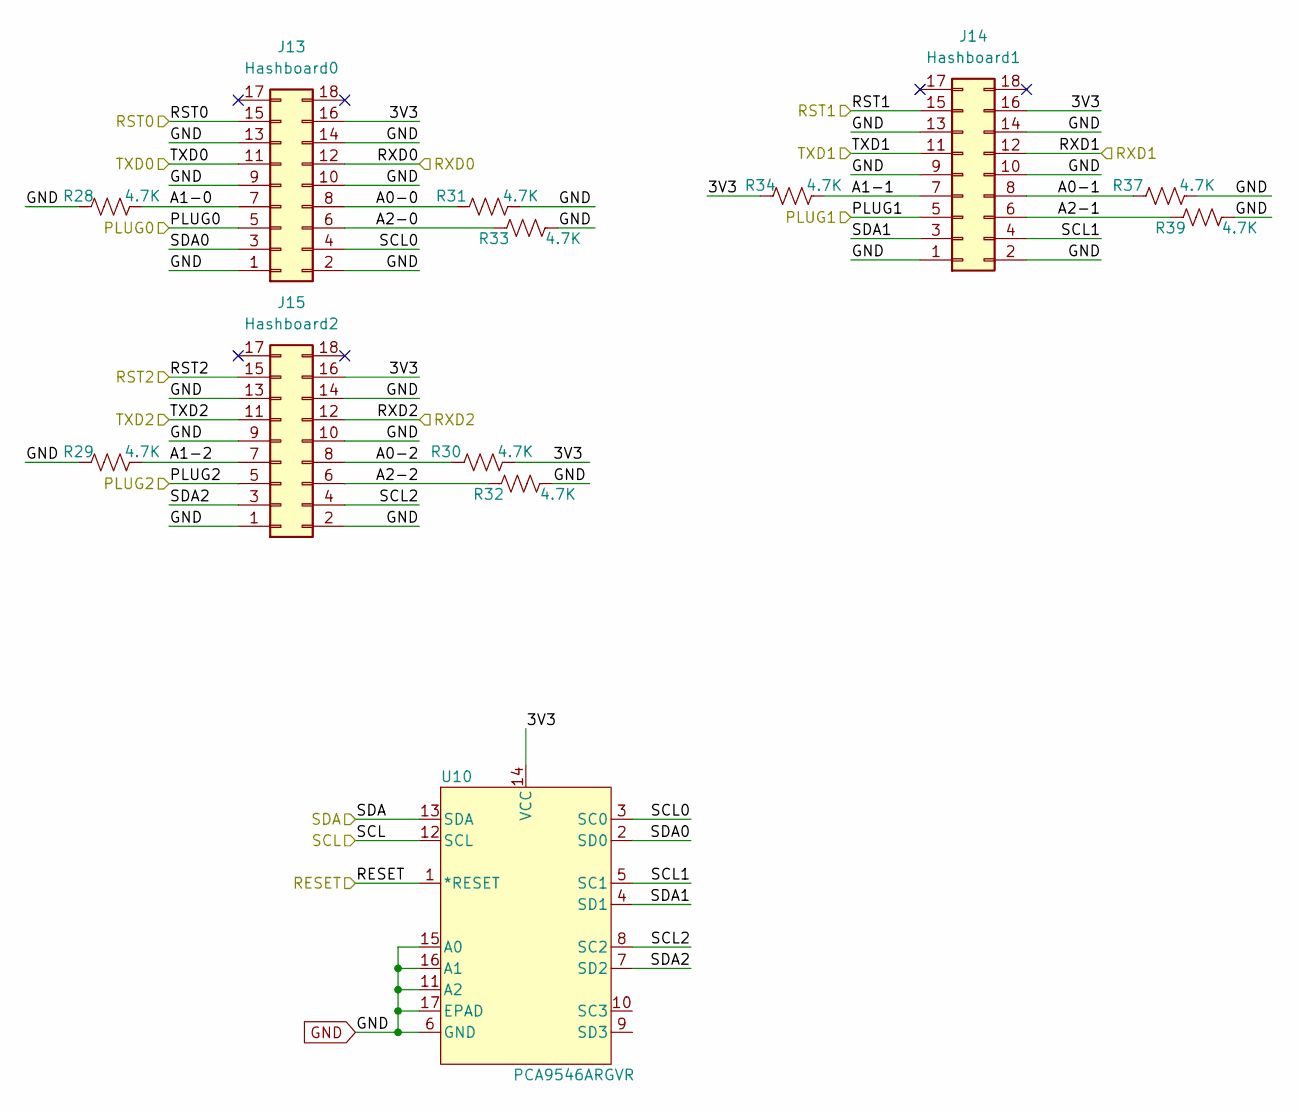
[picture p9: schematic hashboards.kicad_sch]

Parts:
J13: Hashboard0; CONN-TH_X2026WV-2-09D-46SN; PARTNO X2026WV-2x09D-46SN; LCSC C437089
J14: Hashboard1; CONN-TH_X2026WV-2-09D-46SN; PARTNO X2026WV-2x09D-46SN; LCSC C437089
J15: Hashboard2; CONN-TH_X2026WV-2-09D-46SN; PARTNO X2026WV-2x09D-46SN; LCSC C437089
R28, R29, R30, R31, R32, R33, R34, R37, R39: 4.7K; R_0402_1005Metric
U10: PCA9546ARGVR; QFN-16_EP_4x4_Pitch0.65mm; PARTNO PCA9546ARGVR

Connections:
/CM4_GPIO ( Ethernet, GPIO, SDCARD)/GPIO4: J14.11; also elsewhere on the board
/CM4_GPIO ( Ethernet, GPIO, SDCARD)/GPIO5: J14.12; also elsewhere on the board
/CM4_GPIO ( Ethernet, GPIO, SDCARD)/GPIO6: J14.5; also elsewhere on the board
/CM4_GPIO ( Ethernet, GPIO, SDCARD)/GPIO7: J14.15; also elsewhere on the board
/CM4_GPIO ( Ethernet, GPIO, SDCARD)/GPIO8: J15.11; also elsewhere on the board
/CM4_GPIO ( Ethernet, GPIO, SDCARD)/GPIO10: J15.5; also elsewhere on the board
/CM4_GPIO ( Ethernet, GPIO, SDCARD)/GPIO11: J15.15; also elsewhere on the board
/CM4_GPIO ( Ethernet, GPIO, SDCARD)/GPIO12: J15.12; also elsewhere on the board
/CM4_GPIO ( Ethernet, GPIO, SDCARD)/GPIO14: J13.11; also elsewhere on the board
/CM4_GPIO ( Ethernet, GPIO, SDCARD)/GPIO15: J13.12; also elsewhere on the board
/CM4_GPIO ( Ethernet, GPIO, SDCARD)/GPIO16: J13.5; also elsewhere on the board
/CM4_GPIO ( Ethernet, GPIO, SDCARD)/GPIO17: J13.15; also elsewhere on the board
/SCL: U10.12 (SCL); also elsewhere on the board
/SDA: U10.13 (SDA); also elsewhere on the board
/hashboards/3V3: J13.16, J14.16, J15.16, R30.2, R34.1, U10.14 (VCC)
/hashboards/A0-0: J13.8, R31.1
/hashboards/A0-1: J14.8, R37.1
/hashboards/A0-2: J15.8, R30.1
/hashboards/A1-0: J13.7, R28.2
/hashboards/A1-1: J14.7, R34.2
/hashboards/A1-2: J15.7, R29.2
/hashboards/A2-0: J13.6, R33.1
/hashboards/A2-1: J14.6, R39.1
/hashboards/A2-2: J15.6, R32.1
/hashboards/RESET: U10.1 (*RESET)
/hashboards/SCL0: J13.4, U10.3 (SC0)
/hashboards/SCL1: J14.4, U10.5 (SC1)
/hashboards/SCL2: J15.4, U10.8 (SC2)
/hashboards/SDA0: J13.3, U10.2 (SD0)
/hashboards/SDA1: J14.3, U10.4 (SD1)
/hashboards/SDA2: J15.3, U10.7 (SD2)

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
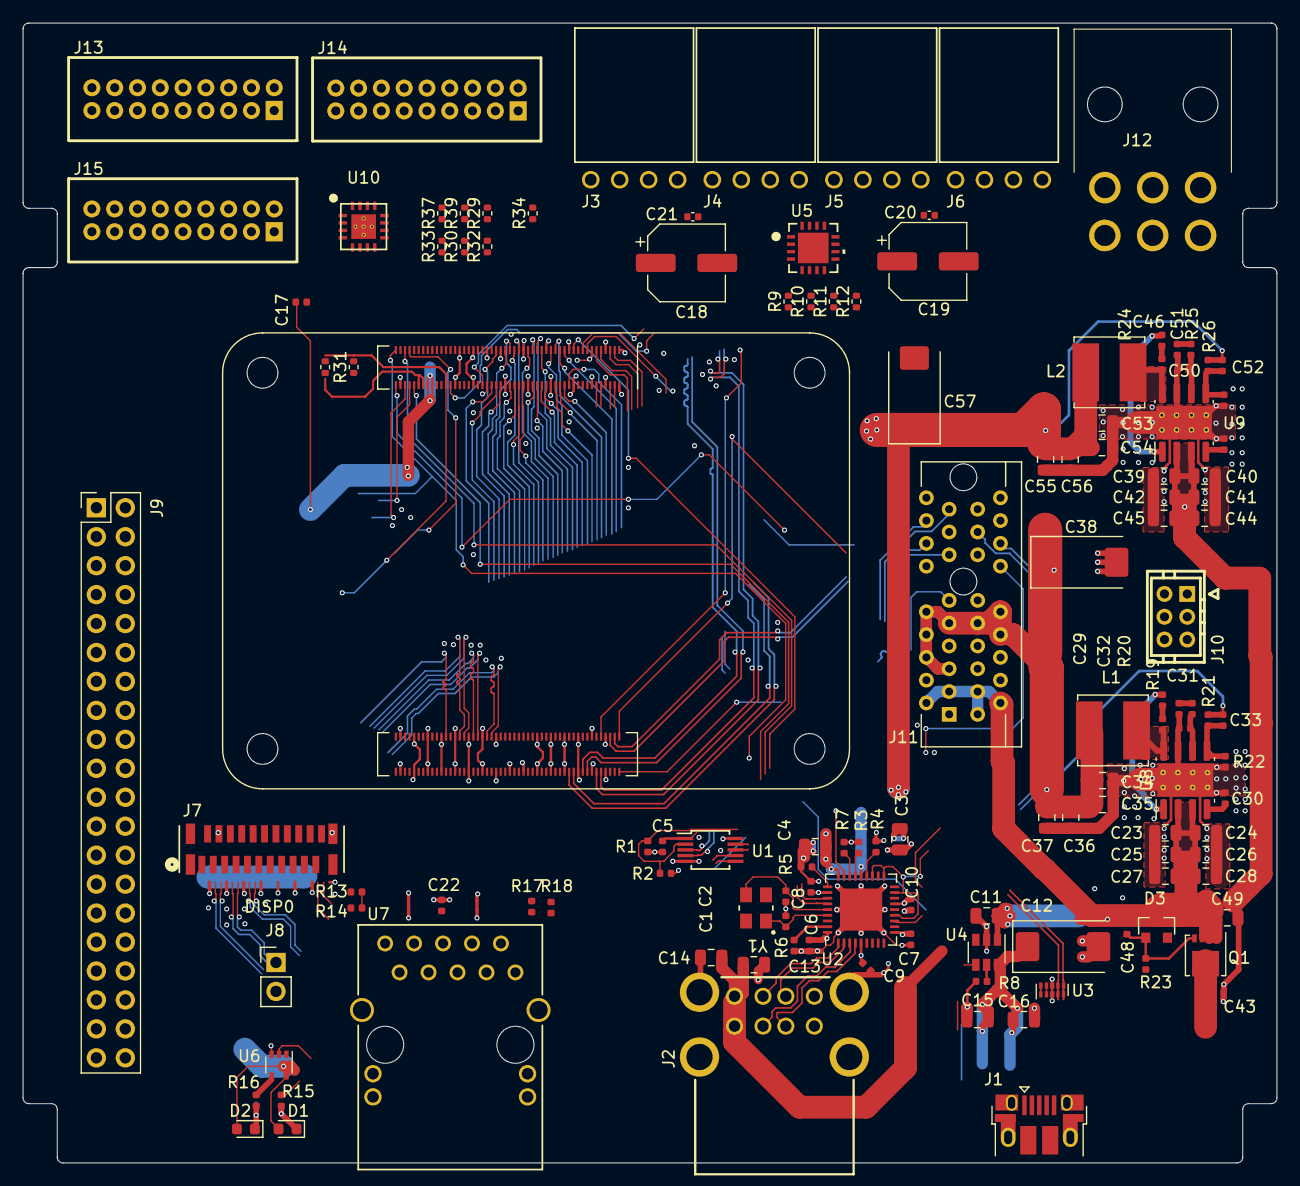
[picture p10: board bitcart.kicad_pcb from above]

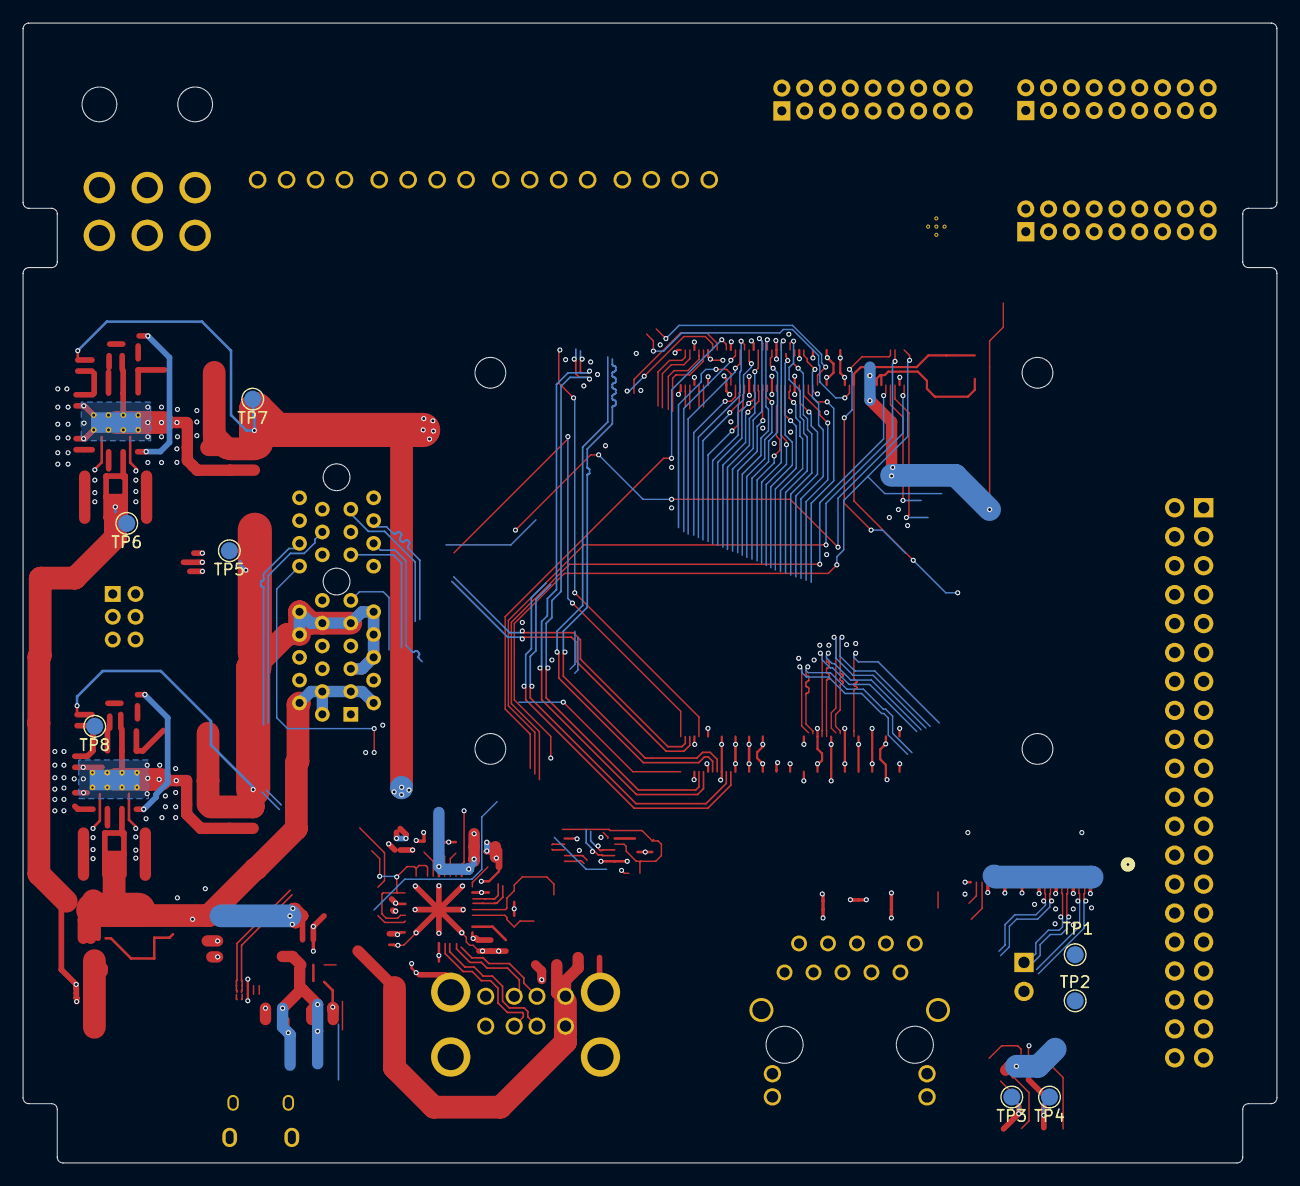
[picture p11: board bitcart.kicad_pcb from below]

Board: 4 copper layers, 110.0 x 100.0 mm, 134 parts (8 on the bottom side), 138 nets.

Other parts of the board:
C18, C19: 220uF; CP_Elec_6.3x7.7
C20, C21: 0.1uF; C_0402_1005Metric
