skot/bitcart/(commit log)

2023-09-14 initial import -- renamed CM4 IO Board
    [CM4_GPIO.kicad_sch, CM4_HighSpeed.kicad_sch, PCIe.kicad_sch, PSUs.kicad_sch, RTC.kicad_sch, USB2-HUB.kicad_sch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]
2023-09-15 removed HDMI, CAM and DISP1 connectors
    [CM4_GPIO.kicad_sch, CM4_HighSpeed.kicad_sch, PCIe.kicad_sch, PSUs.kicad_sch, RTC.kicad_sch, USB2-HUB.kicad_sch, bitcart.kicad_sch]
2023-09-15 added hashboard connectors. added GPU power connector
    [CM4_GPIO.kicad_sch, PSUs.kicad_sch, bitcart.kicad_sch, hashboards.kicad_sch]
2023-09-20 extended the board to make room for IO connectors. added the vertical display connector.
    [CM4_GPIO.kicad_sch, CM4_HighSpeed.kicad_sch, PCIe.kicad_sch, PSUs.kicad_sch, RTC.kicad_sch, USB2-HUB.kicad_sch, bitcart.kicad_pcb, bitcart.kicad_sch]
2023-09-20 added the PSU control connector.
    [CM4_GPIO.kicad_sch, PCIe.kicad_sch, USB2-HUB.kicad_sch, bitcart.kicad_pcb, bitcart.kicad_sch]
2023-10-13 finding/adding digikey part numbers
    [CM4_GPIO.kicad_sch, CM4_HighSpeed.kicad_sch, PCIe.kicad_sch, USB2-HUB.kicad_sch]
2023-10-13 added a lot more parts
    [CM4_GPIO.kicad_sch, PCIe.kicad_sch, PSUs.kicad_sch, RTC.kicad_sch, USB2-HUB.kicad_sch, bitcart.kicad_sch]
2023-10-15 added the right board outline. rotated the CM4. switched to single-shroud RA fan connectors
    [RTC.kicad_sch, bitcart.kicad_pcb]
2023-10-15 add render
    [bitcart.kicad_pcb]
2023-10-17 resolved some schematic-board errors. switched to tap-on-top ethernet.
    [CM4_GPIO.kicad_sch, CM4_HighSpeed.kicad_sch, PCIe.kicad_sch, PSUs.kicad_sch, RTC.kicad_sch, USB2-HUB.kicad_sch, bitcart.kicad_pcb, bitcart.kicad_sch]
